projet-chauffe-au-solaire/Mathieu/répartition des tâches.odt

Système | Gestion Installation solaire thermique ECS | | | | Système éclairage scénique
Taches | Étudiant 1 | Étudiant 2 | Étudiant 3 | Étudiant 4 | Étudiant 1 | Étudiant 2 | Étudiant 3 | Étudiant 4 | Étudiant 5
| UL | | | UG | Table DMX | Projecteur à leds | | Projecteur laser
Descriptif | Commande et positionnement du réflecteur (UL) | Traiter les commandes de l’UG en fonction des sécurités (UL) | Commande des circulateurs en fonction des températures. (UL) Acquisition de la direction et de la force du vent et de la luminosité . Mémorisation des données. | Acquisition et affichage des consignes de l’utilisateur et transmission des données à la carte UL. Commande du circulateur secondaire (UG) | Réalisation de l’IHM Création et transmission des trames au format DMX . Alimentation en énergie. | Gestion et communication des données Commande des leds | Acquisition du son et du rythme sonore et du mode de fonctionnement Gestion de l’alimentation | Gestion des données et communication DMX. Commandes moteur pas à pas. | Acquisition du son et du rythme sonore et du mode de fonctionnement Gestion de l’alimentation.
Noms Prénoms | | | | Dupont Matéo | Louineau Elie
