projet-chauffe-au-solaire/Mathieu/(list of files, drawings)

Other design files:
carte UL partie adressage.pdsprj
routage partie adressage v1.pdsprj
routage partie adressage v2.pdsprj
routage partie adressage v3.pdsprj
routage partie adressage v4 x plan de masse.pdsprj
routage partie adressage v4.pdsprj
routage partie adressage v5.1.pdsprj
routage partie adressage v5.2 plan de masse.pdsprj
routage partie adressage v5.2.pdsprj
routage partie adressage v5.pdsprj
routage partie adressage v6.pdsprj
routage partie adressage v7.pdsprj
routage partie adressage v8 avec pdm.pdsprj
routage partie adressage v8 sans plan de masse.pdsprj
routage partie adressage.pdsprj
