projet-chauffe-au-solaire/Mathieu/Rapport de projet sur activité le gestion installation solaire thermique ECS.odt

Rapport de projet sur activité le gestion installation solaire thermique ECS

Création du diagramme de mission

Composant | Max 3485ESA+ | LED yellow smd | LED green smd | LED RED SMD | LTC 485CS8 | AMS 1117
Information composant | Validé | Forward voltage : typ :2V (If= 20mA) A commander | Min 1.5V Typ 1.9V Max 2.1V If= 2 mA Reverse courant (Vr=5V)= 10Ua VALIDE | Forward voltage : 1.8 à 2.4V (If= 2Ma VALIDE | A COMMANDER | 5V VALIDE

Composant | Condo 100nF/0.1Uf 1206 | Condo 220 uF | 424108600 | Resistance 10k | Resistance 1k 330; 1.2k, 120, 820 | 1N4001 | CMS11
| A COMMANDER | Valider (dans boîte orange | A COMMANDER 0,46€. | A commander 0,26 | VALIDER | A commander 0.03 (lot de 5000) | Valider

Dans la nomenclature le condo 220 uF n’est pas le même qu’au lycée mais tranquille cela n’a pas d’importance vu qu’on le possède déjà

Calcul résistance yellow : U= R*I R= U/I= 2/20*10^-3 =100

Résistance green : : U= R*I R= U/I= 2/2*10^-3 =1000

Résistance RED : : U= R*I R= U/I= 2/20*10^-3 =100

Dimension ancienne carte : longueur = 20cm

Largeur 14.8 cm

VALIDE= dans le lycée

J’ai changé le micro contrôler par un plus récent

Avant : PIC16F877

Maintenant : ESP32DEVKIT1

Changer valeur des résistances pour les LED

Passage des LED en CMS

Avec valeurs bonne résistance

Cavalier de poser sur ESP32DEVKIT1 pour éviter deux entrée de tension en même temps

Mini sxitch cms

Changer valeur res

Changer toujours mini swith
