projet-chauffe-au-solaire/Mathieu/Rapport de projet sur activité le gestion installation solaire thermique ECS 1.odt

Mathieu 2024-2025

RIALLAND

BTS CIEL 2 option ER

Lycée Jean Delattre de Tassigny

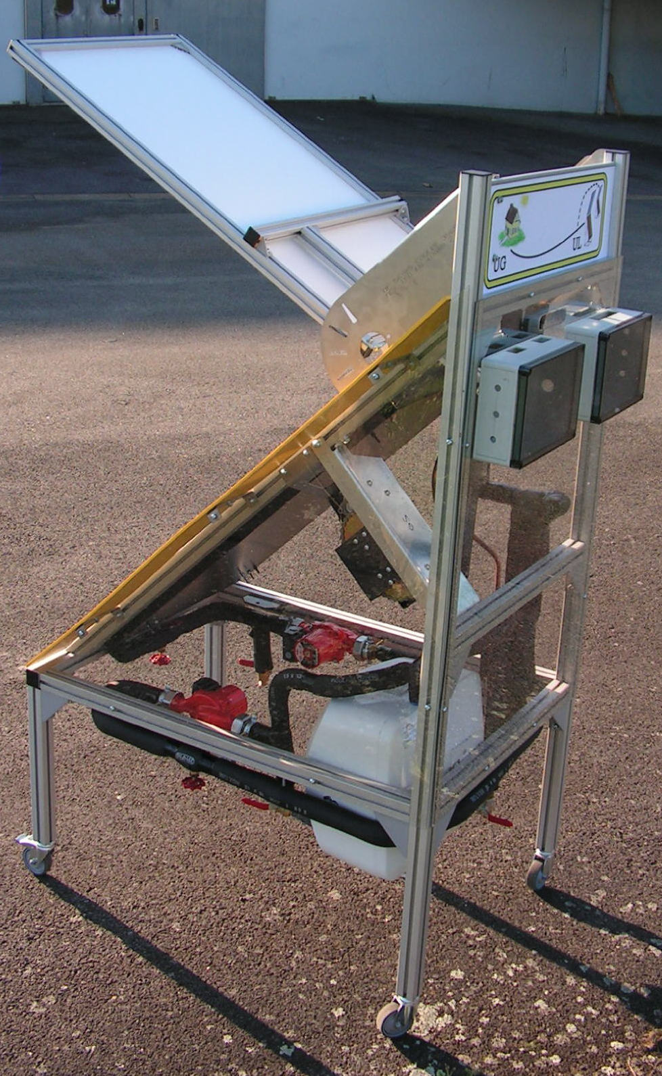
[picture p1: figure]

Rapport de projet sur le projet gestion installation panneau solaire thermique ECS

2 Mathieu RIALLAND
