projet-chauffe-au-solaire/Mathieu/Lors des test j.odt

Lors des test j’ai remarquer que ma diode était a l’envers j’ai du la changer de sens

J’ai effectuer tous mes test clef dans excel

Rajout d’un fil GND d’un bornier a toute la masse

Rajout d’un fil GND qui part de ESP pour aller à la masse

Envoie d’un message sur le max, fonctionnement normal

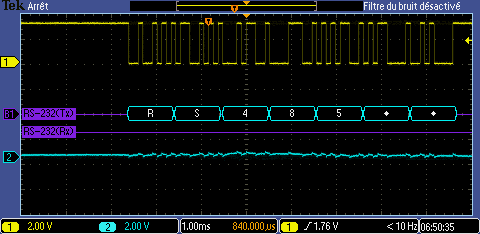
[picture p2: figure]

LED 9 ne marchait pas : manque fil 3.3V, problème de tableau dans le programme (j’avais créé un tableau avec 10 valeurs ([9]vu que l’on commence initiation à 0 alors qui en fallait que 9 [8]

Banc de test communication entre les RJ 45

Les deux cartes communiquent ensemble, j’ai effectué un deuxième montage d’un ESP 32 avec un Max et un RJ45. Je lui ai demander d’afficher un message sur la première carte et sur la deuxième elle reçoit l’information.

Simulation de test effecteur

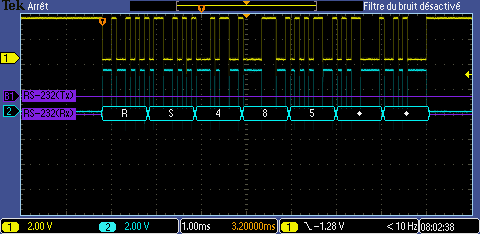
[picture p3: figure]

Résultat obtenu au bornes du RJ 45

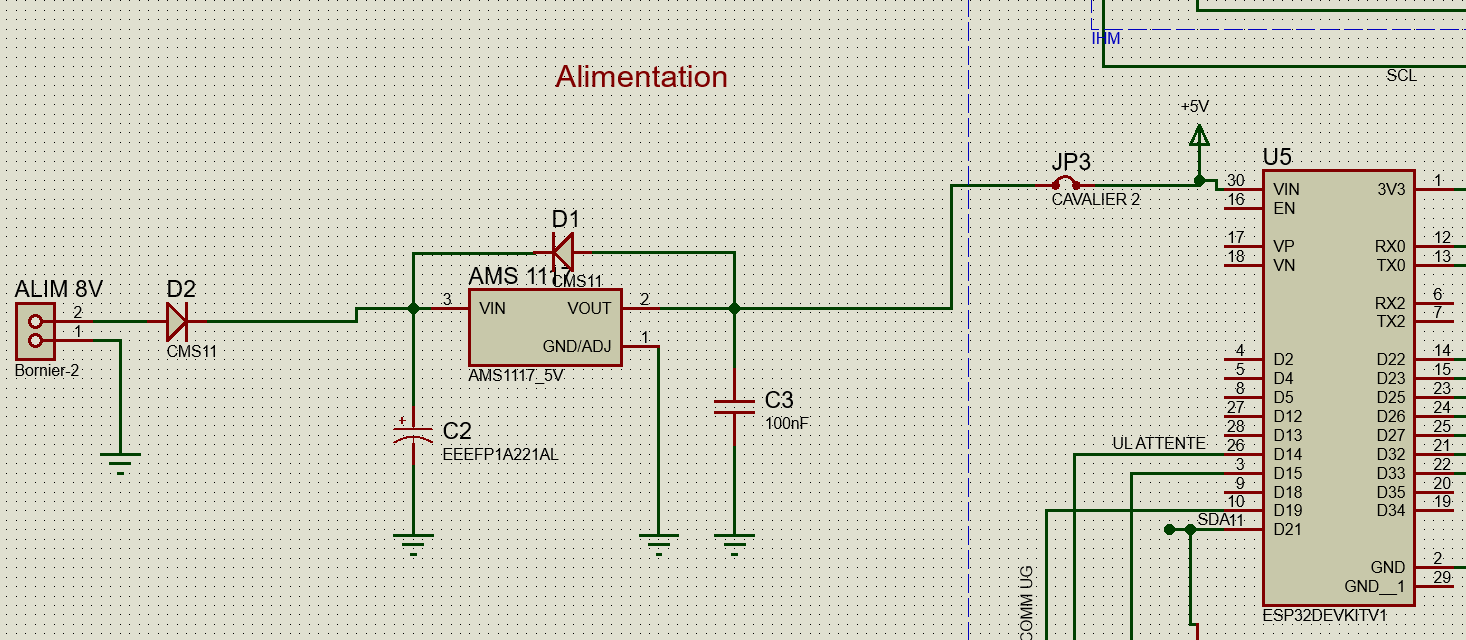
[picture p4: figure]

Tension de 0V (GND)

Cavalier : protège ESP 32 quand on branche avec 8V. Le cavalier doit être enlever

Sortie AMS 5V

8V DC

Diode Schottky : perte de 0.3V donc tension de 7.7V

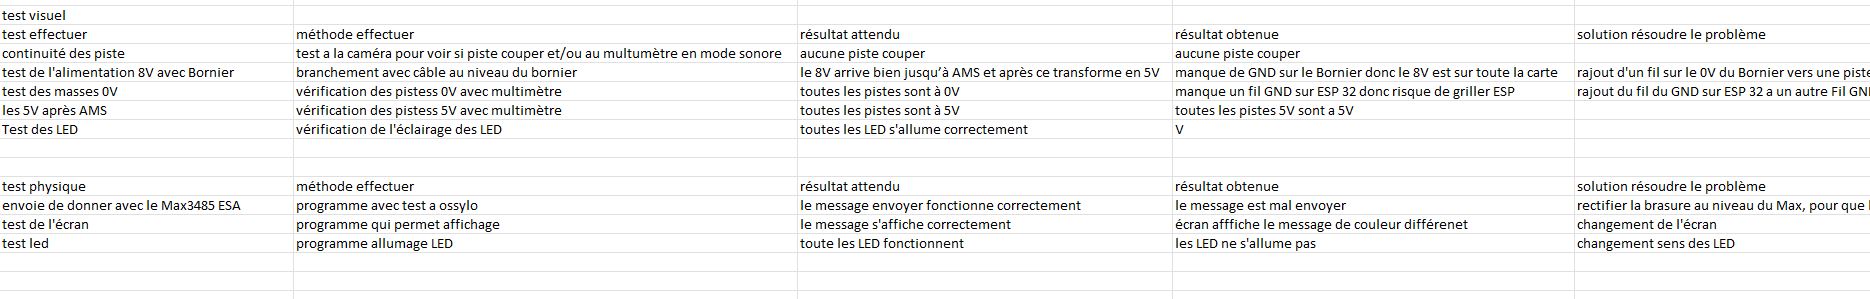
[picture p5: figure]
