projet-chauffe-au-solaire/Mathieu/TEST.xlsx

test de conductivité | okay
test du 5V | okay
test du GND | okay
Test visuel des LED | okay
Test LED
Test des RJ45
Test de l'écran
Test du 8V au patte du bornier et jusqu’à AMS | okay
test visuel
test effectuer | méthode effectuer | résultat attendu | résultat obtenue | solution résoudre le problème
continuité des piste | test a la caméra pour voir si piste couper et/ou au multumètre en mode sonore | aucune piste couper | aucune piste couper | 0
test de l'alimentation 8V avec Bornier | branchement avec câble au niveau du bornier | le 8V arrive bien jusqu’à AMS et après ce transforme en 5V | manque de GND sur le Bornier donc le 8V est sur toute la carte | rajout d'un fil sur le 0V du Bornier vers une piste GND
test des masses 0V | vérification des pistess 0V avec multimètre | toutes les pistes sont à 0V | manque un fil GND sur ESP 32 donc risque de griller ESP | rajout du fil du GND sur ESP 32 a un autre Fil GND
les 5V après AMS | vérification des pistess 5V avec multimètre | toutes les pistes sont à 5V | toutes les pistes 5V sont a 5V | 0
Test des LED | vérification de l'éclairage des LED | toutes les LED s'allume correctement
test physique | méthode effectuer | résultat attendu | résultat obtenue | solution résoudre le problème
envoie de donner avec le Max3485 ESA | programme avec test a ossylo | le message envoyer fonctionne correctement | le message est mal envoyer | rectifier la brasure au niveau du Max, pour que le message s'envoie directement
test de l'écran | programme qui permet affichage | le message s'affiche correctement | écran afffiche le message de couleur différenet | changement de l'écran
test led | programme allumage LED | toute les LED fonctionnent | les LED ne s'allume pas | changement sens des LED
